roncarr880/uSDX_Teensy/usdx_wiring.png

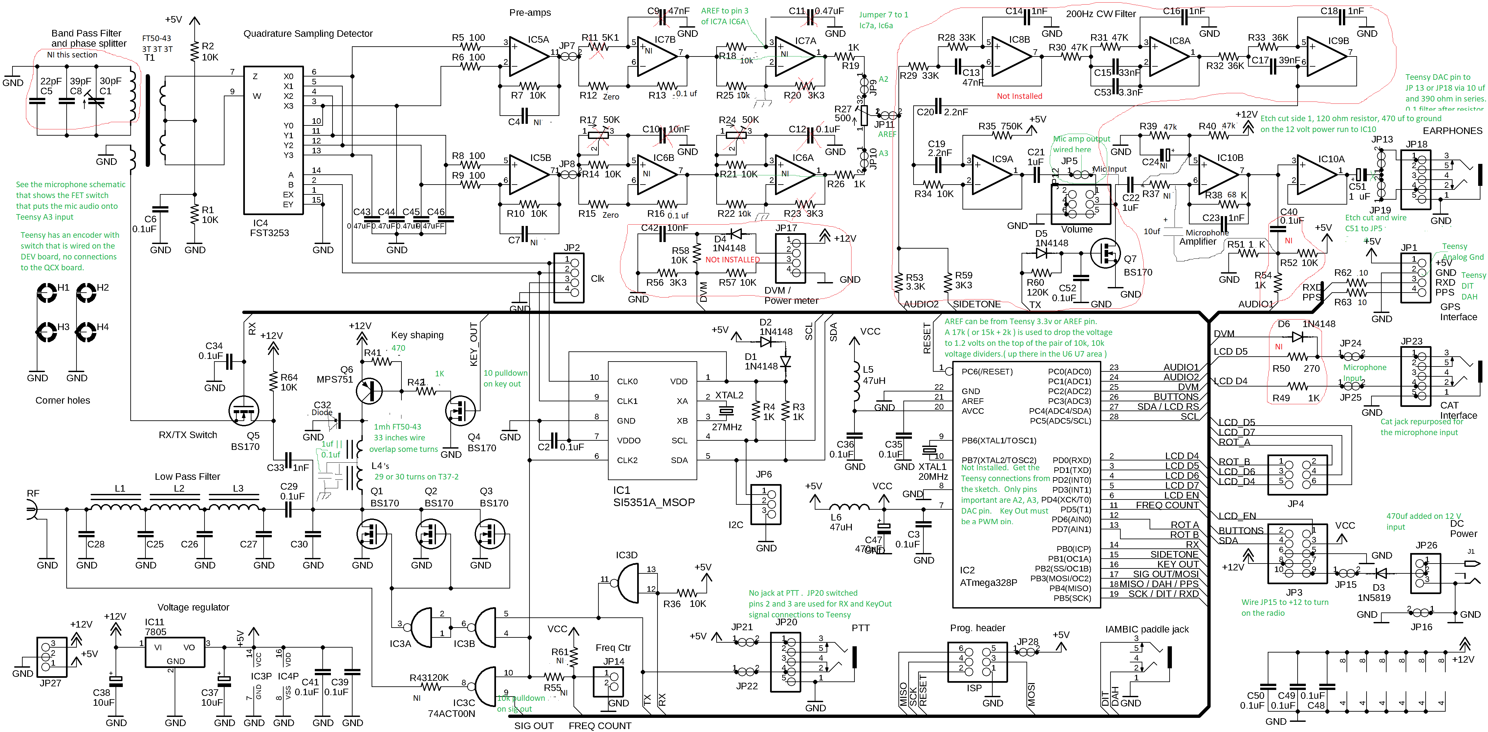
usdx_wiring.png
