roncarr880/uSDX_Teensy/saved/filters.h

const int16_t  IQlow[32] = {

(int16_t)( 32767.5 * 0.006932955032979961 ),
(int16_t)( 32767.5 *  0.007328194664143261 ),
(int16_t)( 32767.5 *  0.007751299256539095 ),
(int16_t)( 32767.5 *  0.004688196183064297 ),
(int16_t)( 32767.5 * -0.002562338359062063 ),
(int16_t)( 32767.5 * -0.013252369418062385 ),
(int16_t)( 32767.5 * -0.024872094729234493 ),
(int16_t)( 32767.5 * -0.033399132520923559 ),
(int16_t)( 32767.5 * -0.034248112925392732 ),
(int16_t)( 32767.5 * -0.023564012720388952 ),
(int16_t)( 32767.5 *  348.5635345830266370E-6 ),
(int16_t)( 32767.5 *  0.036068340611728832 ),
(int16_t)( 32767.5 *  0.078869921353266315 ),
(int16_t)( 32767.5 *  0.121534971357958127 ),
(int16_t)( 32767.5 *  0.155968015154093531 ),
(int16_t)( 32767.5 *  0.175197610839971901 ),
(int16_t)( 32767.5 *  0.175197610839971901 ),
(int16_t)( 32767.5 *  0.155968015154093531 ),
(int16_t)( 32767.5 *  0.121534971357958127 ),
(int16_t)( 32767.5 *  0.078869921353266315 ),
(int16_t)( 32767.5 *  0.036068340611728832 ),
(int16_t)( 32767.5 *  348.5635345830266370E-6 ),
(int16_t)( 32767.5 * -0.023564012720388952 ),
(int16_t)( 32767.5 * -0.034248112925392732 ),
(int16_t)( 32767.5 * -0.033399132520923559 ),
(int16_t)( 32767.5 * -0.024872094729234493 ),
(int16_t)( 32767.5 * -0.013252369418062385 ),
(int16_t)( 32767.5 * -0.002562338359062063 ),
(int16_t)( 32767.5 *  0.004688196183064297 ),
(int16_t)( 32767.5 *  0.007751299256539095 ),
(int16_t)( 32767.5 *  0.007328194664143261 ),
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
( int16_t )( 32767.5 * -0.000132896691888540 ),
( int16_t )( 32767.5 * -0.001677481242764034 ),
( int16_t )( 32767.5 * -0.002462687414618585 ),
( int16_t )( 32767.5 * -0.002548046432798863 ),
( int16_t )( 32767.5 * -0.002145947131161530 ),
( int16_t )( 32767.5 * -0.001517080425276766 ),
( int16_t )( 32767.5 * -0.000886242722567442 ),
( int16_t )( 32767.5 * -0.000395405981442630 ),
( int16_t )( 32767.5 * -0.000095490163490865 ),
( int16_t )( 32767.5 *  0.000033347998217575 ),
( int16_t )( 32767.5 *  0.000048367883266899 ),
( int16_t )( 32767.5 *  0.000012316547490673 ),
( int16_t )( 32767.5 * -0.000027788462267387 )
};

*/
