roncarr880/uSDX_Teensy/ParksLPF36.h

  // fc 2.87 at 44117 sample rate
const int16_t TXLowc[36] = { 
  (int16_t)( 32767.5 * 0.004622950665326221 ),
 (int16_t)( 32767.5 *  0.003102883251607454 ),
 (int16_t)( 32767.5 *  0.002355965861557671 ),
 (int16_t)( 32767.5 * -212.9445887300952340E-6 ),
 (int16_t)( 32767.5 * -0.004764649034902365 ),
 (int16_t)( 32767.5 * -0.010884923958759656 ),
 (int16_t)( 32767.5 * -0.017487995796258406 ),
 (int16_t)( 32767.5 * -0.022880875462825894 ),
 (int16_t)( 32767.5 * -0.024981244388363452 ),
 (int16_t)( 32767.5 * -0.021783532107904069 ),
 (int16_t)( 32767.5 * -0.011781031933756984 ),
 (int16_t)( 32767.5 *  0.005532062287462879 ),
 (int16_t)( 32767.5 *  0.029384608676057911 ),
 (int16_t)( 32767.5 *  0.057668669787036553 ),
 (int16_t)( 32767.5 *  0.087162909492430121 ),
 (int16_t)( 32767.5 *  0.114034442913316020 ),
 (int16_t)( 32767.5 *  0.134514453863635197 ),
 (int16_t)( 32767.5 *  0.145587128394631615 ),
 (int16_t)( 32767.5 *  0.145587128394631615 ),
 (int16_t)( 32767.5 *  0.134514453863635197 ),
 (int16_t)( 32767.5 *  0.114034442913316020 ),
 (int16_t)( 32767.5 *  0.087162909492430121 ),
 (int16_t)( 32767.5 *  0.057668669787036553 ),
 (int16_t)( 32767.5 *  0.029384608676057911 ),
 (int16_t)( 32767.5 *  0.005532062287462879 ),
 (int16_t)( 32767.5 * -0.011781031933756984 ),
 (int16_t)( 32767.5 * -0.021783532107904069 ),
 (int16_t)( 32767.5 * -0.024981244388363452 ),
 (int16_t)( 32767.5 * -0.022880875462825894 ),
 (int16_t)( 32767.5 * -0.017487995796258406 ),
 (int16_t)( 32767.5 * -0.010884923958759656 ),
 (int16_t)( 32767.5 * -0.004764649034902365 ),
 (int16_t)( 32767.5 * -212.9445887300952340E-6 ),
 (int16_t)( 32767.5 *  0.002355965861557671 ),
 (int16_t)( 32767.5 *  0.003102883251607454 ),
 (int16_t)( 32767.5 *  0.004622950665326221 )
};
